AxioncoreLabs/AxionRover/README.md

<p align="center">
  
  
</p>

# AxionRover

个人两轮差速小车: ESP32 + TB6612 + 编码器。开环速度, 编码器直行 `d`、转角 `r`。对应ROS`/cmd_vel`的 v–ω。**不是**SLAM/Nav2自研; 阶段二已对接ROS2串口。

## 操作手册

[book/zh/00-目录.md](book/zh/00-目录.md)

- **10x 阶段一**: 101烧录 → 106样车验证  
- **20x 阶段二**: ROS2接入(Pi 5 + Jazzy, `/cmd_vel`串口桥, 见`ros2/`)
- **30x 阶段三**: 导航(未开始)

英文目录: [book/en/00-contents.md](book/en/00-contents.md)

## 阶段一

- 直行：`d 0.96` ≈ 1 m（开环, 横向几乎无偏移）
- 转角：`r ±90` / `r ±180`（编码器停角, 实测几乎无偏差）
- 轨距 `L = 0.159 m`（外边距 185 mm − 轮宽 26 mm）

## 阶段二

- 车载：Raspberry Pi 5 8GB，Ubuntu Server 24.04，ROS 2 **Jazzy**（`ros-base`，无桌面）
- `/cmd_vel`（`linear.x` / `angular.z`）→ 串口 `c <v> <w>`，固件仍是 `DiffDrive` 速度环；空格停车
- 节点：[ros2/axion_serial_bridge](ros2/axion_serial_bridge)；Windows 不装 ROS，用 [tools/serial_teleop.py](tools/serial_teleop.py)
- 电源：主开关 ON、VIN 断开，派 USB 接 ESP32；丢包约 2 s 超时停
- 不是激光、建图、Nav2。步骤见 [book/zh/200-ROS2接入.md](book/zh/200-ROS2接入.md)

## 演示

- A 路开环：[YouTube](https://www.youtube.com/shorts/FS3IdpszdbM) · [Bilibili](https://www.bilibili.com/video/BV1PCHp6ZEFa/)
- B 路开环：[YouTube](https://www.youtube.com/shorts/xwJDwbOH4fE) · [Bilibili](https://www.bilibili.com/video/BV1skHp6bE7Z/)
- AB 双路：[YouTube](https://www.youtube.com/shorts/fDkDXerzhRc) · [Bilibili](https://www.bilibili.com/video/BV1PkHp6bE5H/)
- 直行约 1 m：[YouTube](https://youtu.be/OrOgSyiR2sc) · [Bilibili](https://www.bilibili.com/video/BV1LJHp65Eb5/)
- 原地 90° / 180°：[YouTube](https://youtu.be/yye5On57KsE) · [Bilibili](https://www.bilibili.com/video/BV1o7Hp61EPy/)
- ROS 2 `/cmd_vel` 键盘遥控：[YouTube](https://www.youtube.com/shorts/JJ2JFrDMi3Q) · [Bilibili](https://www.bilibili.com/video/BV1NEHg64Ecr/)

## 仓库结构

```text
book/zh/          操作手册（00 目录，10x / 20x / 30x）
book/en/          英文目录
sketchbook/       Arduino 工程（文件夹名 = .ino 名）
tools/            Windows 串口遥控（Pi 前，非 ROS）
ros2/             Jazzy：cmd_vel → DiffDrive 串口（派上编译）
images/           配图(101-01.png与章节编号一致)
```

## 许可

[MIT](LICENSE) · AxioncoreLabs
