AxioncoreLabs/AxionRover/sketchbook/README.md

# sketchbook/

Arduino sketches. Folder name must match the `.ino` name.

| Folder | Manual |
|---|---|
| `Blink` / `SerialTest` | 101 |
| `MotorOpenLoopTest` / `MotorOpenLoopTest_AB` | 102 |
| `EncoderTest_A` / `EncoderTest_B` | 103 |
| `EncoderCal` / `SpeedPI_*` / `DiffDrive` | 105；DiffDrive 也用于 106 |
