AxioncoreLabs/AxionRover/book/zh/00-目录.md

<p align="center">
  
  
</p>

# AxionRover 操作手册 · 00 目录

**101 烧录 → 102 开环 → 103 编码器 → 104 电源定型 → 105 PID → 106 样车验证**

英文：[book/en/00-contents.md](../en/00-contents.md)

## 阶段一 · 底盘bring-up

| 编号 | 文档 | Sketch |
|---|---|---|
| 101 | [ESP32 串口与烧录](101-ESP32串口与烧录.md) | Blink、SerialTest |
| 102 | [TB6612 开环](102-TB6612开环.md) | MotorOpenLoopTest、AB |
| 103 | [JGB37-520 编码器](103-编码器读脉冲.md) | EncoderTest_A / EncoderTest_B |
| 104 | [电源定型](104-电源定型.md) | VIN、LM2596、四态 |
| 105 | [PID / 差速](105-速度PI与差速.md) | EncoderCal、SpeedPI、DiffDrive |
| 106 | [样车验证](106-样车验证.md) | 装车、清单图、直行 `d`、旋转 `r` |

## 阶段二 · ROS2接入

| 编号 | 文档 | 说明 |
|---|---|---|
| 200 | [ROS2接入](200-ROS2接入.md) | Pi 5 + Jazzy，`/cmd_vel` → 串口 `c v w` |

## 阶段三 · 导航 · 未开始

| 编号 | 文档 |
|---|---|
| 300 | [导航](300-导航.md) |
