AxioncoreLabs/AxionRover/images/README.md

# images/

`{chapter}-{seq}.jpg` or `.png` — chapter id = Markdown number.

| Prefix | Section |
|---|---|
| `101-` | ESP32 / COM / Blink / Serial |
| `102-` | TB6612 开环（含厂商图、Serial） |
| `103-` | 编码器 |
| `104-` | 电源定型 |
| `105-` | PI / DiffDrive |
| `106-` | 样车验证（装车图、清单图） |
| `200-` | ROS 接入（三路电源、Imager、Jazzy、验收） |

From `book/zh/` use `../../images/102-01.png`. No Chinese or spaces in filenames.
