AxioncoreLabs/AxionRover/book/zh/300-导航.md

<p align="center">
  
  
</p>

> 操作手册 · 阶段三 · 300 · 导航 · [00 目录](00-目录.md) · [阶段二 200](200-ROS2接入.md)

---

# 300 导航

**状态：未开始。** 阶段二 [200](200-ROS2接入.md) 已完成后再写。

预定范围（会拆成 301、302…）：路标 / 点位、任务层对接现有差速底盘。业务层对接，非 SLAM / Nav2 算法自研。

正文待补。
