AxioncoreLabs/AxionRover/book/zh/200-ROS接入.md

<p align="center">
  
  
</p>

> 操作手册 · 阶段二 · 200 · ROS 接入 · [00 目录](00-目录.md) · [阶段一 106](106-样车验证.md) · [阶段三 300](300-导航.md)

---

# 200 ROS 接入

**状态：未开始。**

预定范围（会拆成 201、202…）：

- 上位机或树莓派 ROS 2 Humble
- `/cmd_vel` → 串口 `v` / `w` / `c`（周期 300～500 ms，避免 DiffDrive 2 s 超时）
- 以实机运动为准，不在本章做 SLAM

正文待补。
